dragonmux/OPLSniffer/hardware/OPLSniffer.brd

## EAGLE design hardware/OPLSniffer.brd (2021-03-06)

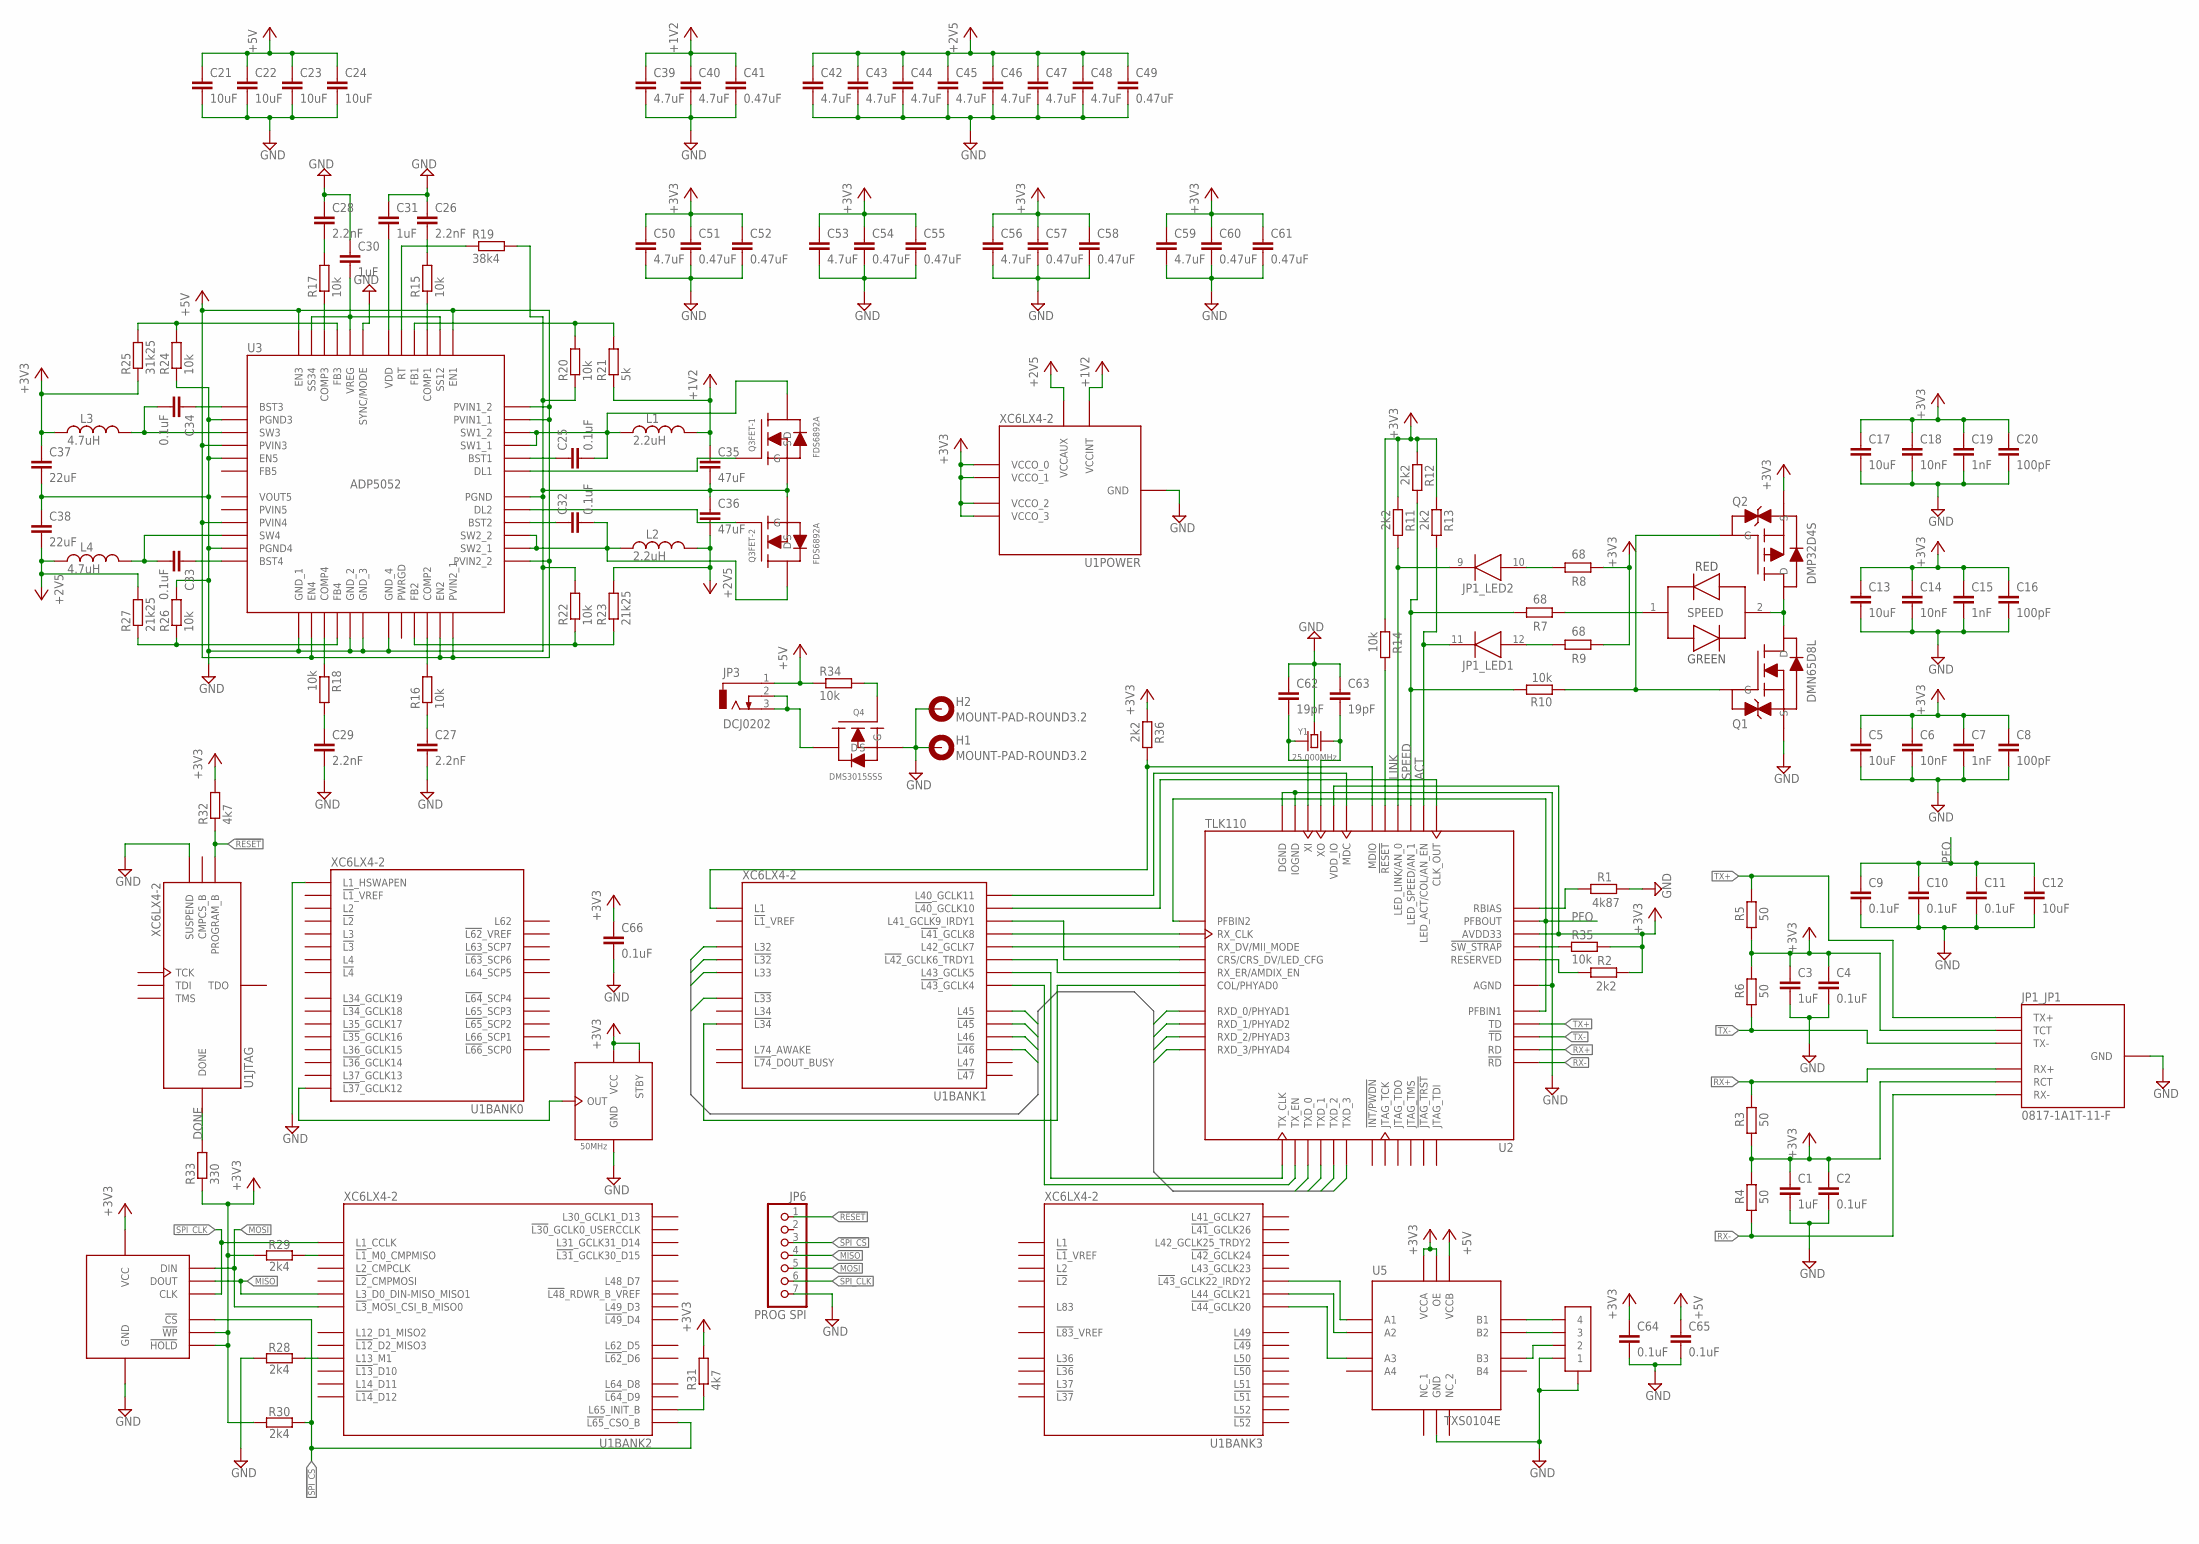
[picture p1: schematic OPLSniffer.sch]

Parts:
C1, C3, C30, C31: 1uF; C0603K; MPN MC0603X105M6R3CT
C2, C4, C9, C10, C11, C25, C32, C33, C34, C64, C65, C66: 0.1uF; C0603K; MPN MC0603B104J250CT
C5, C12, C13, C17, C22, C23, C24: 10uF; C0805K; MPN MC0805X106K250CT
C6, C14, C18: 10nF; C0603K; MPN MCCA000238
C7, C15, C19: 1nF; C0603K; MPN MC0603B102K500CT
C8, C16, C20: 100pF; C0603K; MPN MCCA001175
C21: 10uF; C0805K; MPN GRM21BR61E106KA73L
C26, C27, C28, C29: 2.2nF; C0603K; MPN MCCA001160
C35, C36: 47uF; C1206K; MPN GRM31CR60J476KE19L
C37, C38: 22uF; C0805K; MPN C0805C226M9PACTU
C39, C40, C42, C43, C44, C45, C46, C47, C48, C50, C53, C56, C59: 4.7uF; C0603K; MPN MC0603X475K6R3CT
C41, C49, C51, C52, C54, C55, C57, C58, C60, C61: 0.47uF; C0603K; MPN MC0603X474K100CT
C62, C63: 19pF; C0603K; MPN C0603C180J5GACTU
H1, H2: MOUNT-PAD-ROUND3.2; 3,2-PAD
JP1: 0817-1A1T-11-F; MPN 0817-1A1T-11-F
JP3: DCJ0202
JP4: OPL2; 53261-0471_PICOBLADE
JP6: PROG SPI; PINHEAD_1X7
L1, L2: 2.2uH; NRS4018; MPN NRS4018T2R2MDGJ
L3, L4: 4.7uH; NRS4018; MPN NRS4018T4R7MDGJ
OSC1: 50MHz; SMD3225; MPN ASE-50.000MHZ-L-R-T
Q1: DMN65D8L; SOT23
Q2: DMP32D4S; SOT23; MPN DMP32D4S-13
Q3: FDS6892A; SOIC8
Q4: DMS3015SSS; SOIC8
R1: 4k87; R0603; MPN CRCW06034K87FKEA
R2, R11, R12, R13, R36: 2k2; R0603; MPN MCMR06X2201FTL
R3, R4, R5, R6: 50; R0603; MPN CRCW060350R0FKEA
R7, R8, R9: 68; R0603; MPN MCMR06X68R0FTL
R10, R14, R15, R16, R17, R18, R20, R22, R24, R26, R34, R35: 10k; R0603; MPN MC0063W0603110K
R19: 38k4; R0603; MPN CRCW060338K3FKEA
R21: 5k; R0603; MPN MC0063W060314K99
R23, R27: 21k25; R0603; MPN MC0063W0603121K5
R25: 31k25; R0603; MPN CRCW060331K6FKEA
R28, R29, R30: 2k4; R0603; MPN MCMR06X2401FTL
R31, R32: 4k7; R0603; MPN MCMR06X4701FTL
R33: 330; R0603; MPN MCMR06X3300FTL
SPEED: RG-LED; CHIPLED_0805; MPN KPB-2012SURKCGKC
U1: XC6LX4-2; TQFP144
U2: TLK110; LQFP48
U3: ADP5052; LFSCP48
U4: M25P16-VMN6P; SOIC8; MPN M25P16-VMN6P
U5: TXS0104E; TSSOP14
Y1: 25.000MHz; SMD3225; MPN MCSJK-7U-25.00-12-10-60-B-10

Connections:
!RESET: JP6.1, R32.1, U1.37 (PROGRAM_B)
!SPI_CS: JP6.3, R30.2, U1.38 (!L65!_CSO_B), U4.1 (!CS)
+1V2: C35.1, C39.1, C40.1, C41.1, L1.2, R21.1, U1.19 (VCCINT), U1.28 (VCCINT), U1.52 (VCCINT), U1.89 (VCCINT), U1.128 (VCCINT)
+2V5: C36.2, C38.2, C42.1, C43.1, C44.1, C45.1, C46.1, C47.1, C48.1, C49.1, L2.2, L4.1, R23.2, R27.2, U1.20 (VCCAUX), U1.36 (VCCAUX), U1.53 (VCCAUX), U1.90 (VCCAUX), U1.129 (VCCAUX)
+3V3: C1.1, C2.1, C3.1, C4.1, C5.1, C6.1, C7.1, C8.1, C13.1, C14.1, C15.1, C16.1, C17.1, C18.1, C19.1, C20.1, C37.1, C50.1, C51.1, C52.1, C53.1, C54.1, C55.1, C56.1, C57.1, C58.1, C59.1, C60.1, C61.1, C64.1, C66.1, JP1.3 (TCT), JP1.6 (RCT), L3.1, OSC1.1 (STBY), OSC1.4 (VCC), Q2.2 (S), R2.2, R3.1, R4.2, R5.1, R6.2, R8.1, R9.1, R11.1, R12.1, R13.1, R14.1, R25.1, R29.1, R30.1, R31.2, R32.2, R33.1, R35.2, R36.1, U1.4 (VCCO_3), U1.18 (VCCO_3), U1.31 (VCCO_3), U1.42 (VCCO_2), U1.63 (VCCO_2), U1.76 (VCCO_1), U1.86 (VCCO_1), U1.103 (VCCO_1), U1.122 (VCCO_0), U1.125 (VCCO_0), U1.135 (VCCO_0), U2.22 (AVDD33), U2.32 (VDD_IO), U2.48 (VDD_IO), U4.3 (!WP), U4.7 (!HOLD), U4.8 (VCC), U5.1 (VCCA), U5.8 (OE)
+5V: C21.1, C22.1, C23.1, C24.1, C65.1, JP3.1, R34.1, U3.4 (PVIN3), U3.9 (PVIN4), U3.14 (EN4), U3.23 (EN2), U3.24 (PVIN2_1), U3.25 (PVIN2_2), U3.35 (PVIN1_1), U3.36 (PVIN1_2), U3.37 (EN1), U3.48 (EN3), U5.14 (VCCB)
ACT: JP1.11 (C), R13.2, U2.26 (LED_ACT/COL/AN_EN)
DONE: R33.2, U1.71 (DONE)
GND: C1.2, C2.2, C3.2, C4.2, C5.2, C6.2, C7.2, C8.2, C9.2, C10.2, C11.2, C12.2, C13.2, C14.2, C15.2, C16.2, C17.2, C18.2, C19.2, C20.2, C21.2, C22.2, C23.2, C24.2, C26.1, C27.2, C28.1, C29.2, C30.1, C31.1, C35.2, C36.1, C37.2, C38.1, C39.2, C40.2, C41.2, C42.2, C43.2, C44.2, C45.2, C46.2, C47.2, C48.2, C49.2, C50.2, C51.2, C52.2, C53.2, C54.2, C55.2, C56.2, C57.2, C58.2, C59.2, C60.2, C61.2, C62.1, C63.1, C64.2, C65.2, C66.2, H1.B3,2, H2.B3,2, JP1.4 (GND), JP1.5 (GND), JP1.GND1 (GND), JP1.GND2 (GND), JP4.1, JP4.GND1 (GND), JP4.GND2 (GND), JP6.7, OSC1.2 (GND), Q1.2 (S), Q3.1 (S), Q3.3 (S), Q4.1 (S), Q4.2 (S), Q4.3 (S), R1.2, R19.2, R20.1, R22.2, R24.1, R26.2, R28.1, U1.3 (GND), U1.13 (GND), U1.25 (GND), U1.49 (GND), U1.54 (GND), U1.68 (GND), U1.73 (SUSPEND), U1.77 (GND), U1.91 (GND), U1.96 (GND), U1.108 (GND), U1.113 (GND), U1.130 (GND), U1.136 (GND), U1.144 (L1_HSWAPEN), U2.15 (AGND), U2.19 (AGND), U2.35 (IOGND), U2.36 (DGND), U2.47 (IOGND), U3.2 (PGND3), U3.5 (EN5), U3.11 (PGND4), U3.13 (GND_1), U3.17 (GND_2), U3.18 (GND_3), U3.19 (GND_4), U3.30 (PGND), U3.43 (SYNC/MODE), U3.PAD (PGND), U4.4 (GND), U5.7 (GND), Y1.2 (GND), Y1.4 (GND)
LINK: JP1.9 (C), R11.2, U2.28 (LED_LINK/AN_0)
MISO: JP6.4, U1.65 (L3_D0_DIN-MISO_MISO1), U4.2 (DOUT)
MOSI: JP6.5, U1.64 (!L3!_MOSI_CSI_B_MISO0), U4.5 (DIN)
unnamed: R1.1, U2.24 (RBIAS)
unnamed: R2.1, U2.20 (RESERVED)
unnamed: JP1.12 (A), R9.2
unnamed: R14.2, U2.29 (!RESET)
unnamed: JP1.10 (A), R8.2
unnamed: R7.1, SPEED.1
unnamed: Q1.3 (D), Q2.3 (D), SPEED.2
unnamed: Q1.1 (G), Q2.1 (G), R10.1
unnamed: U1.85 (L43_GCLK5), U2.1 (TX_CLK)
unnamed: C62.2, U2.34 (XI), Y1.1
unnamed: U1.84 (!L43!_GCLK4), U2.2 (TX_EN)
unnamed: U1.87 (!L42!_GCLK6_TRDY1), U2.41 (RX_ER/AMDIX_EN)
unnamed: U1.88 (L42_GCLK7), U2.39 (RX_DV/MII_MODE)
unnamed: U1.92 (!L41!_GCLK8), U2.38 (RX_CLK)
unnamed: U1.94 (!L40!_GCLK10), U2.25 (CLK_OUT)
unnamed: U1.95 (L40_GCLK11), U2.31 (MDC)
unnamed: R36.2, U1.105 (L1), U2.30 (MDIO)
unnamed: OSC1.3 (OUT), U1.123 (!L37!_GCLK12)
unnamed: C32.2, L2.1, Q3.7 (D), Q3.8 (D), U3.26 (SW2_1), U3.27 (SW2_2)
unnamed: C28.2, R17.2
unnamed: R18.1, U3.15 (COMP4)
unnamed: R16.2, U3.22 (COMP2)
unnamed: R15.1, U3.39 (COMP1)
unnamed: R17.1, U3.46 (COMP3)
unnamed: C26.2, R15.2
unnamed: C25.2, L1.1, Q3.5 (D), Q3.6 (D), U3.33 (SW1_1), U3.34 (SW1_2)
unnamed: C29.1, R18.2
unnamed: C27.1, R16.1
unnamed: C30.2, U3.38 (SS12), U3.44 (VREG), U3.47 (SS34)
unnamed: C31.2, U3.42 (VDD)
unnamed: C25.1, U3.32 (BST1)
unnamed: C32.1, U3.28 (BST2)
unnamed: R20.2, R21.2, U3.40 (FB1)
unnamed: C34.1, U3.1 (BST3)
unnamed: C34.2, L3.2, U3.3 (SW3)
unnamed: C33.1, U3.12 (BST4)
unnamed: C33.2, L4.2, U3.10 (SW4)
unnamed: R19.1, U3.41 (RT)
unnamed: JP3.2, JP3.3, Q4.5 (D), Q4.6 (D), Q4.7 (D), Q4.8 (D)
unnamed: R28.2, U1.60 (L13_M1)
unnamed: Q3.2 (G), U3.29 (DL2)
unnamed: Q3.4 (G), U3.31 (DL1)
unnamed: R22.1, R23.1, U3.21 (FB2)
unnamed: R24.2, R25.2, U3.45 (FB3)
unnamed: R26.1, R27.1, U3.16 (FB4)
unnamed: R29.2, U1.69 (!L1!_M0_CMPMISO)
unnamed: R31.1, U1.39 (L65_INIT_B)
unnamed: C63.2, U2.33 (XO), Y1.3 (2)
unnamed: Q4.4 (G), R34.2
unnamed: JP4.2, U5.11 (B3)
unnamed: JP4.3, U5.12 (B2)
unnamed: JP4.4, U5.13 (B1)
unnamed: U1.16 (!L43!_GCLK22_IRDY2), U5.2 (A1)
unnamed: U1.15 (L44_GCLK21), U5.3 (A2)
unnamed: U1.14 (!L44!_GCLK20), U5.4 (A3)
unnamed: U1.93 (L41_GCLK9_IRDY1), U2.40 (CRS/CRS_DV/LED_CFG)
unnamed: U1.97 (!L34), U2.42 (COL/PHYAD0)
unnamed: R35.1, U2.21 (!SW_STRAP)
PFO: C9.1, C10.1, C11.1, C12.1, U2.18 (PFBIN1), U2.23 (PFBOUT), U2.37 (PFBIN2)
PVIN5: U3.8 (PVIN5)
RX+: JP1.7 (RX+), R3.2, U2.14 (RD)
RX-: JP1.8 (RX-), R4.1, U2.13 (!RD)
RXD0: U1.102 (L32), U2.43 (RXD_0/PHYAD1)
RXD1: U1.101 (!L32), U2.44 (RXD_1/PHYAD2)
RXD2: U1.100 (L33), U2.45 (RXD_2/PHYAD3)
RXD3: U1.99 (!L33), U2.46 (RXD_3/PHYAD4)
SPEED: R7.2, R10.2, R12.2, U2.27 (LED_SPEED/AN_1)
SPI_CLK: JP6.6, U1.70 (L1_CCLK), U4.6 (CLK)
TX+: JP1.1 (TX+), R5.2, U2.17 (TD)
TX-: JP1.2 (TX-), R6.1, U2.16 (!TD)
TXD0: U1.83 (L45), U2.3 (TXD_0)
TXD1: U1.82 (!L45), U2.4 (TXD_1)
TXD2: U1.81 (L46), U2.5 (TXD_2)
TXD3: U1.80 (!L46), U2.6 (TXD_3)
VOUT5: U3.7 (VOUT5)

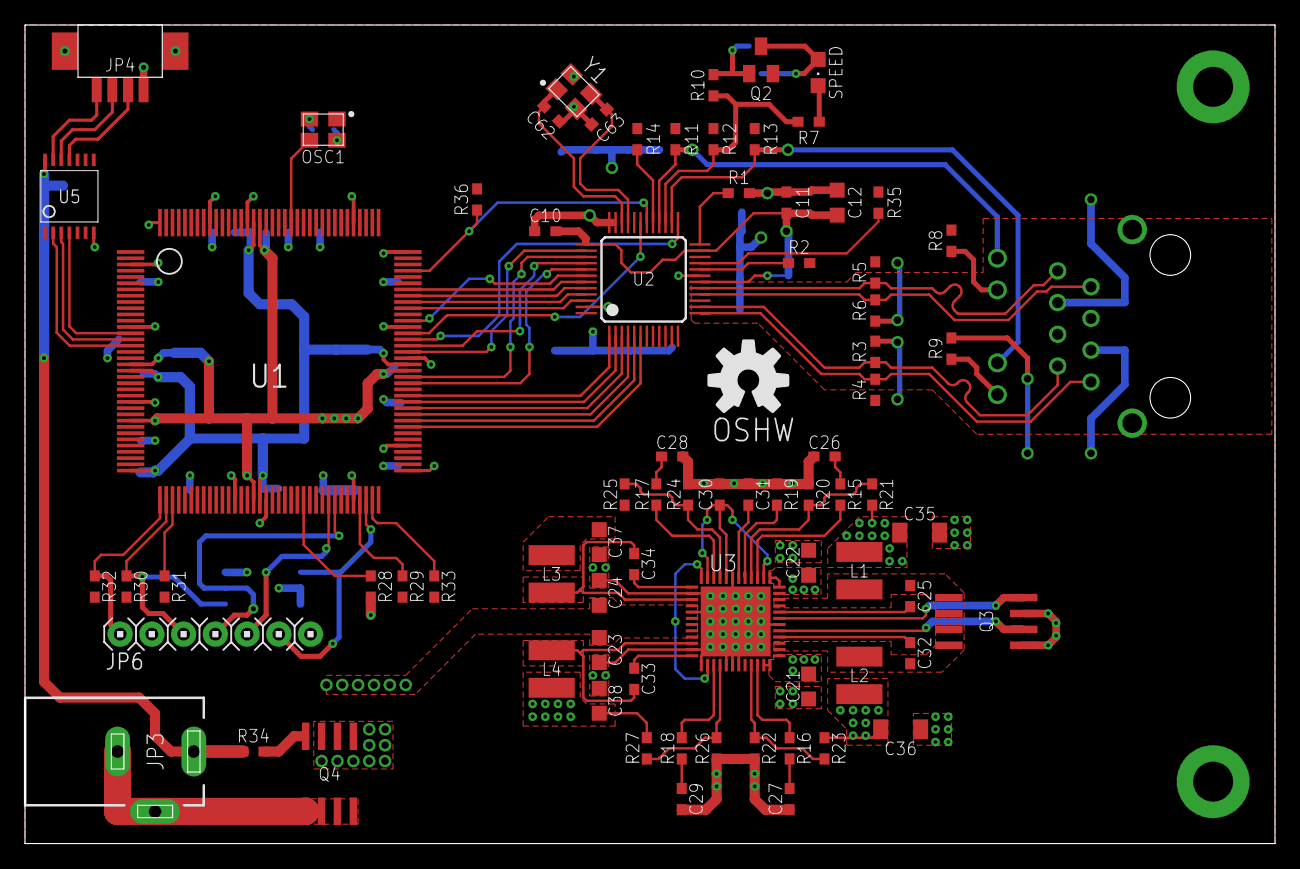
[picture p2: board OPLSniffer.brd from above]

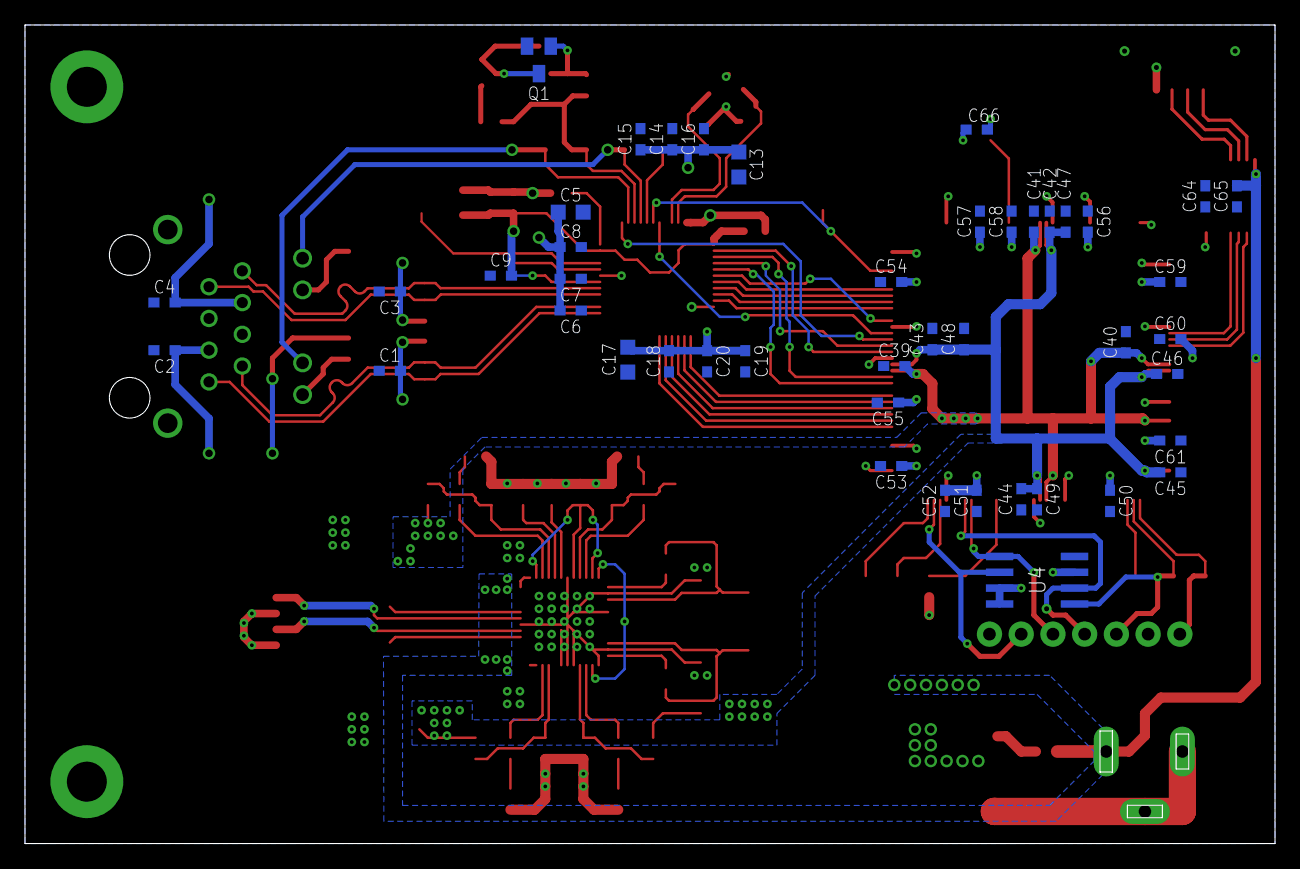
[picture p3: board OPLSniffer.brd from below]

Board: 2 copper layers, 100.1 x 65.5 mm, 124 parts (45 on the bottom side), 85 nets.
