dragonmux/OPLSniffer/(commit log)

2021-01-29 Begun implementing a nMigen-based platform/SoC for the OPLSniffer board
2021-01-30 Fleshed out the interface for Sniffer some more, hooking various signals up to the sample BRAM
2021-01-30 Hooked up a couple of signals to the GPIOs to stop the design being completely optimised out
2021-01-30 Fixed a Vivado-templates-breaking specification for pull-up on the reset signal
    [platform.py]
2021-01-30 Defined the 50MHz clock the current design has available
2021-01-31 Bonded out the processor peripheral data bits to pins to prevent the tools from optimising it out entirely
    [oplSniffer.py, platform.py]
2021-01-31 Bonded the ROM to the processor to prevent the tools from optimising the processor out
    [oplSniffer.py]
2021-01-31 Switched the PIC16 instruction decoder to be comb rather than sync
2021-03-06 Added the Eagle version of the board to the repo for completeness
    [OPLSniffer.brd, OPLSniffer.sch]
2021-07-17 Seperated out the read and write halfs of the PIC p-bus to solve a multiple drivers conflict
2021-07-17 Implemented a test bed for iCEBreaker Bitsy to allow easier test and dev of the PIC core
2021-07-19 Fixed the sim-ability of the Bitsty IOWO elaboratable
    [bitsy.py]
2021-07-19 Correct the cycle timings for the peripherals in IOWO
    [bitsy.py]
2021-07-19 Implemented reset elongation for the processor so it can set its first cycle up correctly
    [bitsy.py]
2021-07-19 Fixed the gpioB.oe assignment as the signal is one bit wide
    [oplSniffer.py]
2021-07-19 Advanced the reset timings in the real gateware same as the test Bitsy gateware
    [oplSniffer.py]
2021-07-19 Fixed the imports in the Bitsy test gateware
    [bitsy.py]
2021-07-19 Switched the real gateware to using the new iBus
2021-07-21 Switched the PIC core over to using the new pBus system
2021-07-21 Fixed up the main OPLSniffer gateware
    [oplSniffer.py]
2021-07-22 Added a PMOD connector as a second GPIO to the test Bitsy gateware
2021-07-22 Fixed up the processor sim and integrated it into the new sim runner
    [main.py]
2021-12-21 Switched nmigen -> amaranth as the upstream project has been renamed
2021-12-21 Switched our platform base to the XilinxPlatform per the deprecation warnings
2021-12-21 Completed a couple of small improvements to the PIC core
